FredricRaab/ExoLab/Images/ExoLab closeup.jpg

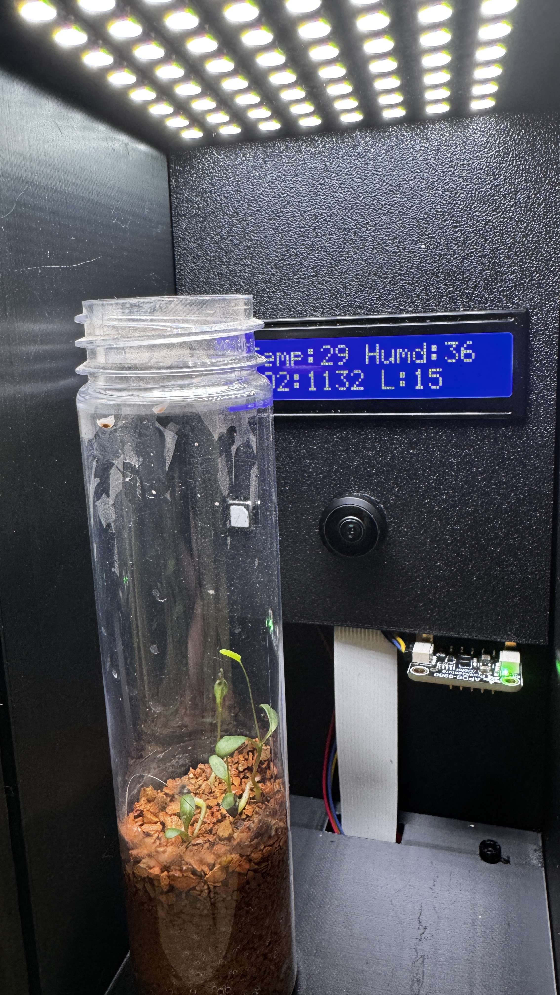
Images/ExoLab closeup.jpg
