FredricRaab/ExoLab/Images/ExoLab empty.jpg

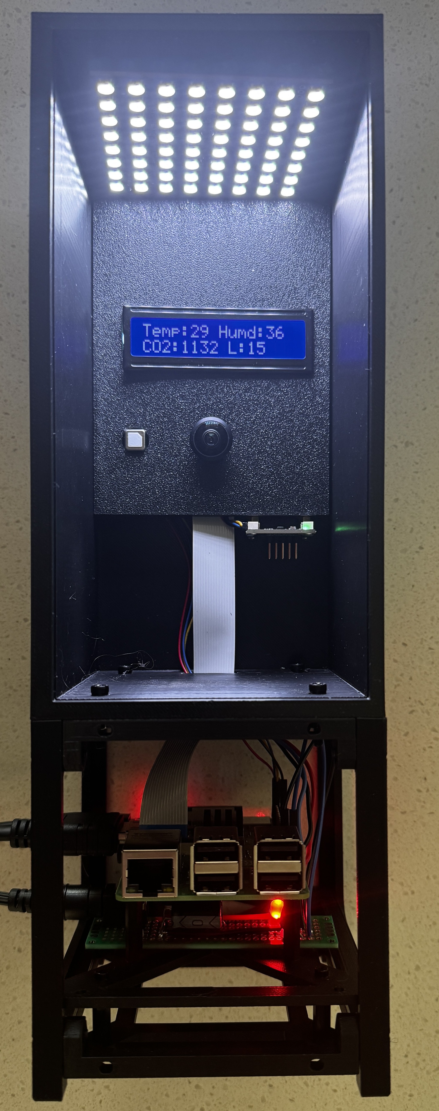
Images/ExoLab empty.jpg
