FredricRaab/ExoLab/STL/README.md

STL files for 3D Printing

Also included are the .3MF files for the Bambu X1 Carbon Printer and 
the Adobe Illustrator file used to lasercut the clear from panel.

Note it is possible to handcut the front panel.
