FredricRaab/ExoLab/Hardware/ExoLab V1 Fritz.jpg

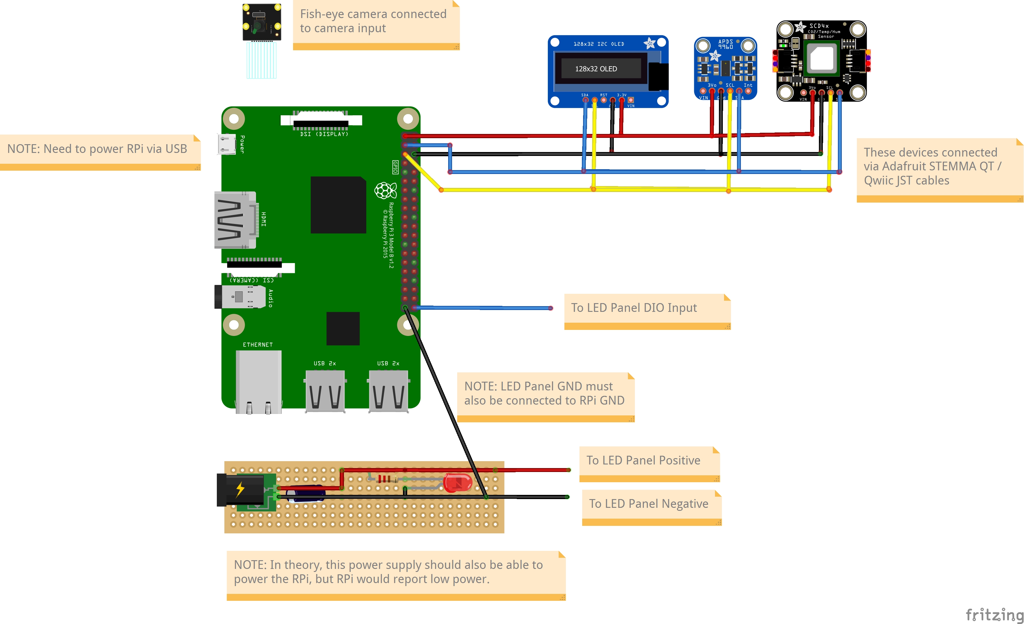
Hardware/ExoLab V1 Fritz.jpg
