FredricRaab/ExoLab/Images/ExoLab with seedlings.jpg

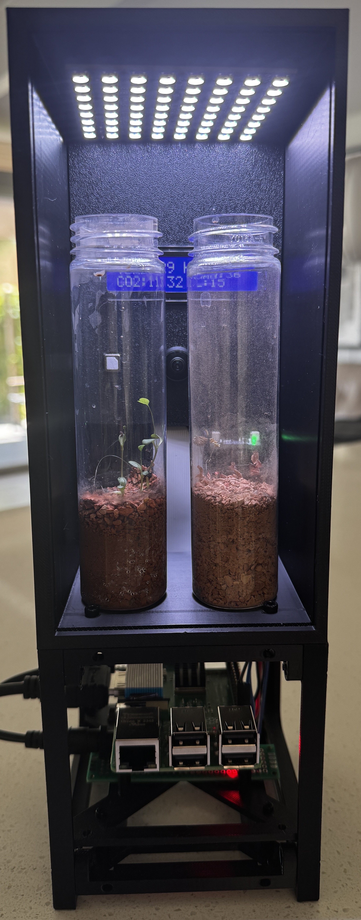
Images/ExoLab with seedlings.jpg
