FredricRaab/ExoLab/STL/ExoLab Electronics V6 ABS.3mf

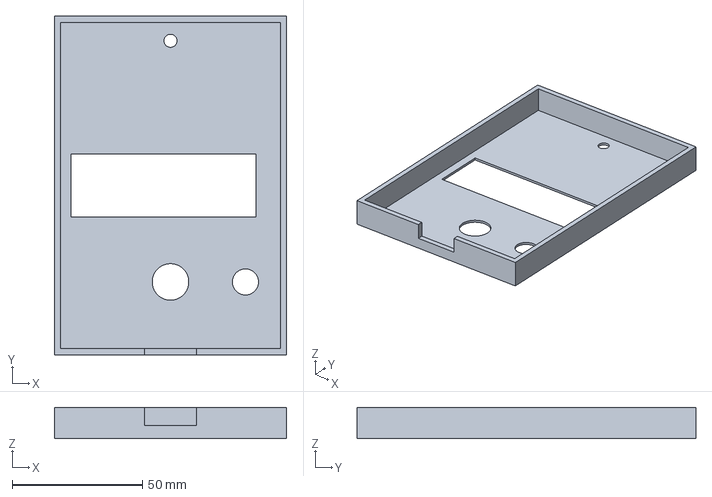
[picture p5: CAD file, 2025-07-09]
STL/ExoLab Electronics V6 ABS.3mf
89.0 x 130.0 x 12.0 mm
