FredricRaab/ExoLab/STL/ExoLab Enclosure V5.6.3mf

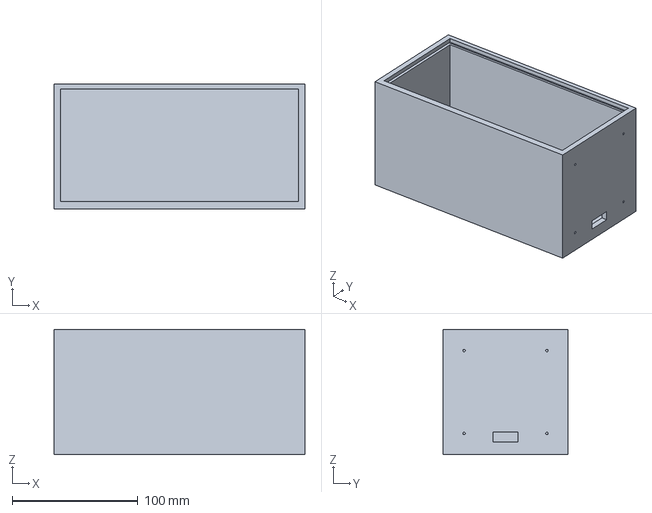
[picture p6: CAD file, 2025-07-09]
STL/ExoLab Enclosure V5.6.3mf
200.0 x 100.0 x 100.0 mm
