FredricRaab/ExoLab/(list of files, cad)

Other CAD files:
STL/ExoLab Electronics V6.stl
STL/ExoLab Enclosure V5.6.stl
