FredricRaab/ExoLab/(list of files, drawings)

Other design files:
Hardware/ExoLab V1.fzz
